kimmoli/saha-display-hw/doc/saha-display_2019-09-14.pdf

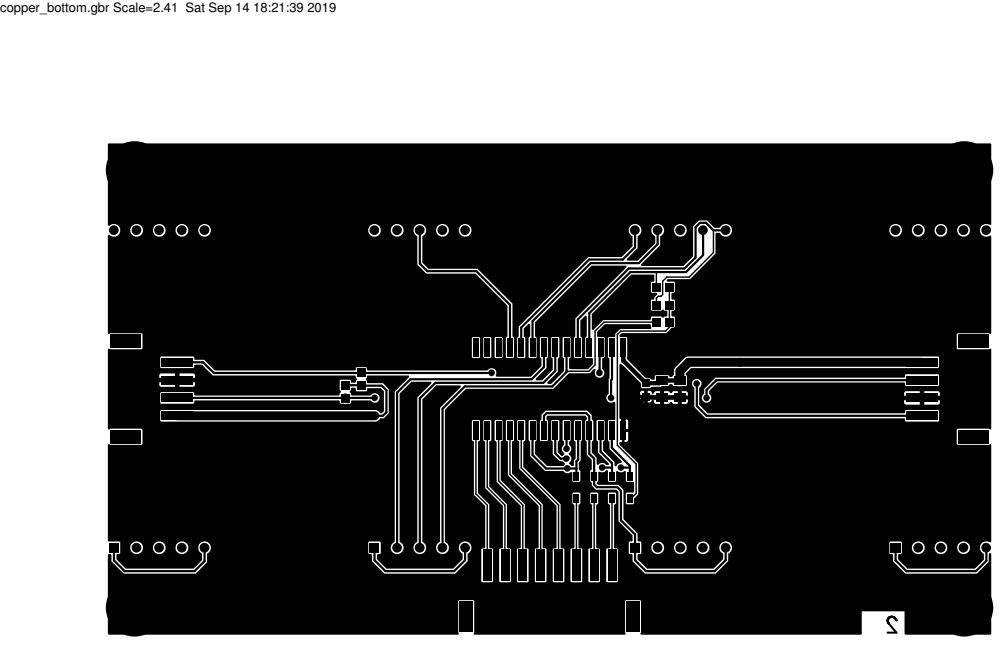
[picture p3: page 1]

copper_bottom.gbr Scale=2.41 Sat Sep 14 18:21:39 2019

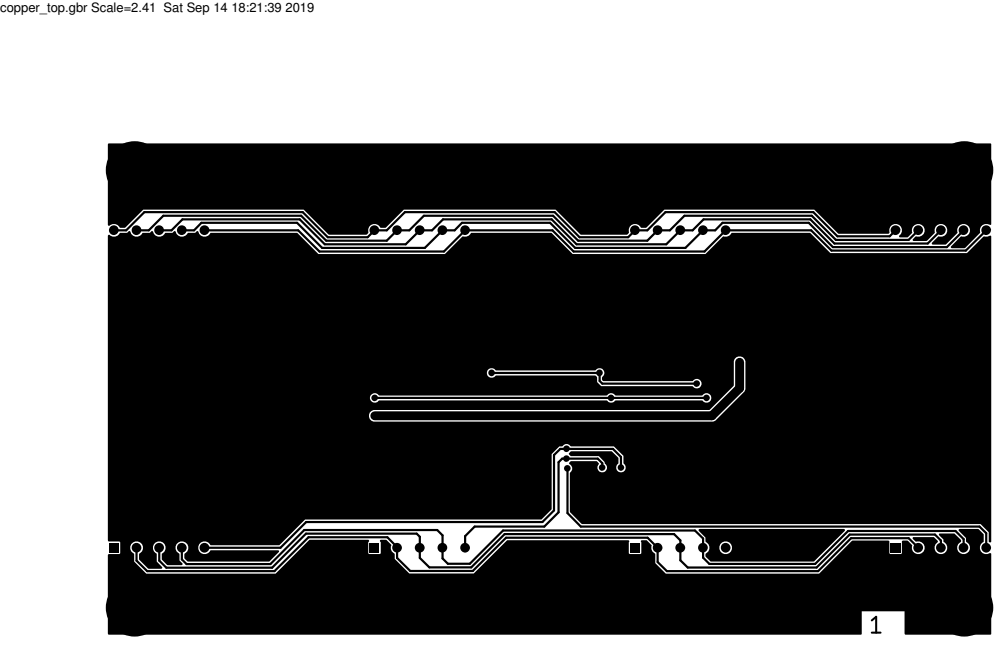
[picture p4: page 2]

copper_top.gbr Scale=2.41 Sat Sep 14 18:21:39 2019

profile.gbr Scale=2.41 Sat Sep 14 18:21:39 2019

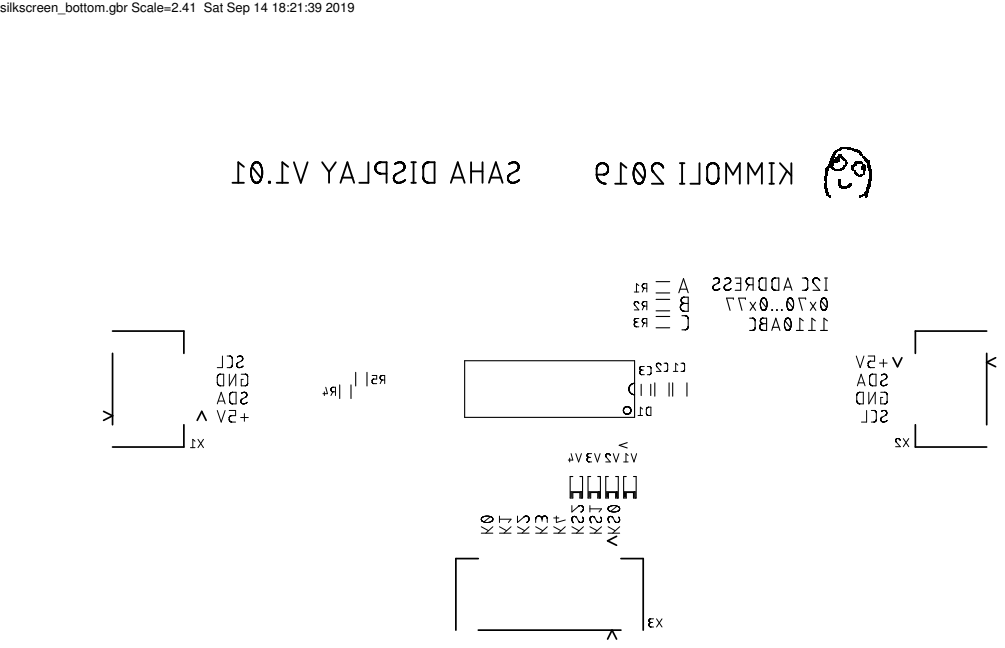
[picture p5: page 4]

silkscreen_bottom.gbr Scale=2.41 Sat Sep 14 18:21:39 2019

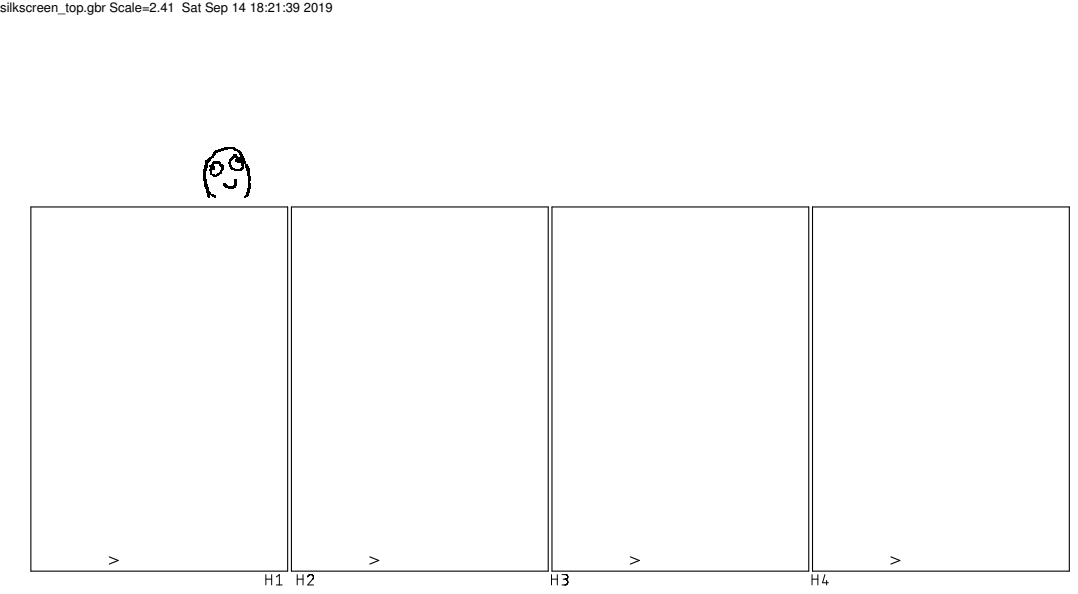
[picture p6: page 5]

silkscreen_top.gbr Scale=2.41 Sat Sep 14 18:21:39 2019

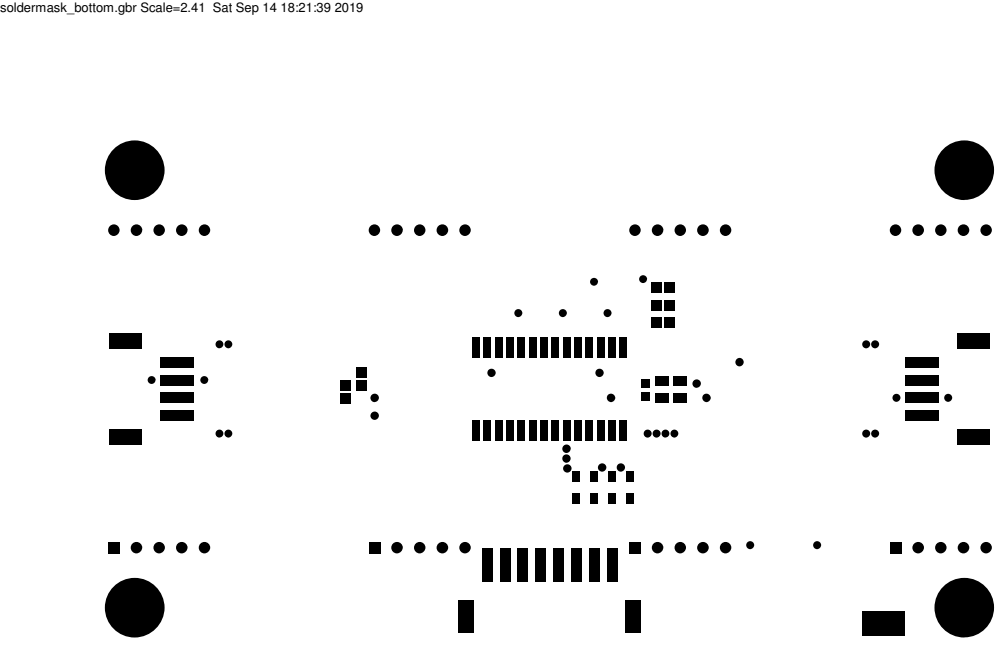
[picture p7: page 6]

soldermask_bottom.gbr Scale=2.41 Sat Sep 14 18:21:39 2019

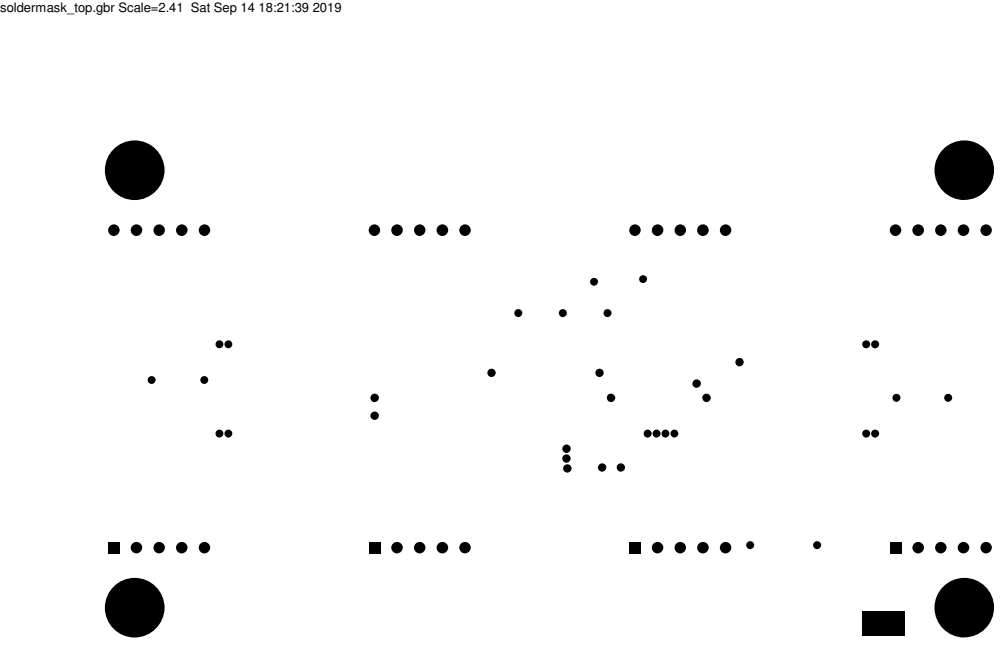
[picture p8: page 7]

soldermask_top.gbr Scale=2.41 Sat Sep 14 18:21:39 2019

solderpaste_bottom.gbr Scale=2.41 Sat Sep 14 18:21:39 2019

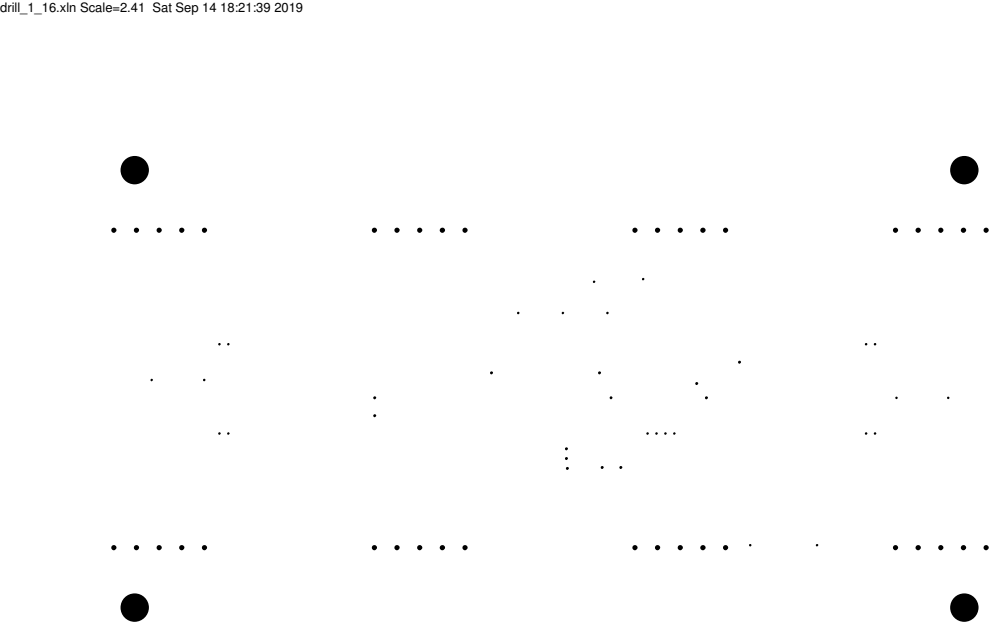
[picture p9: page 9]

drill_1_16.xln Scale=2.41 Sat Sep 14 18:21:39 2019
