kimmoli/saha-display-hw/doc/schema.pdf

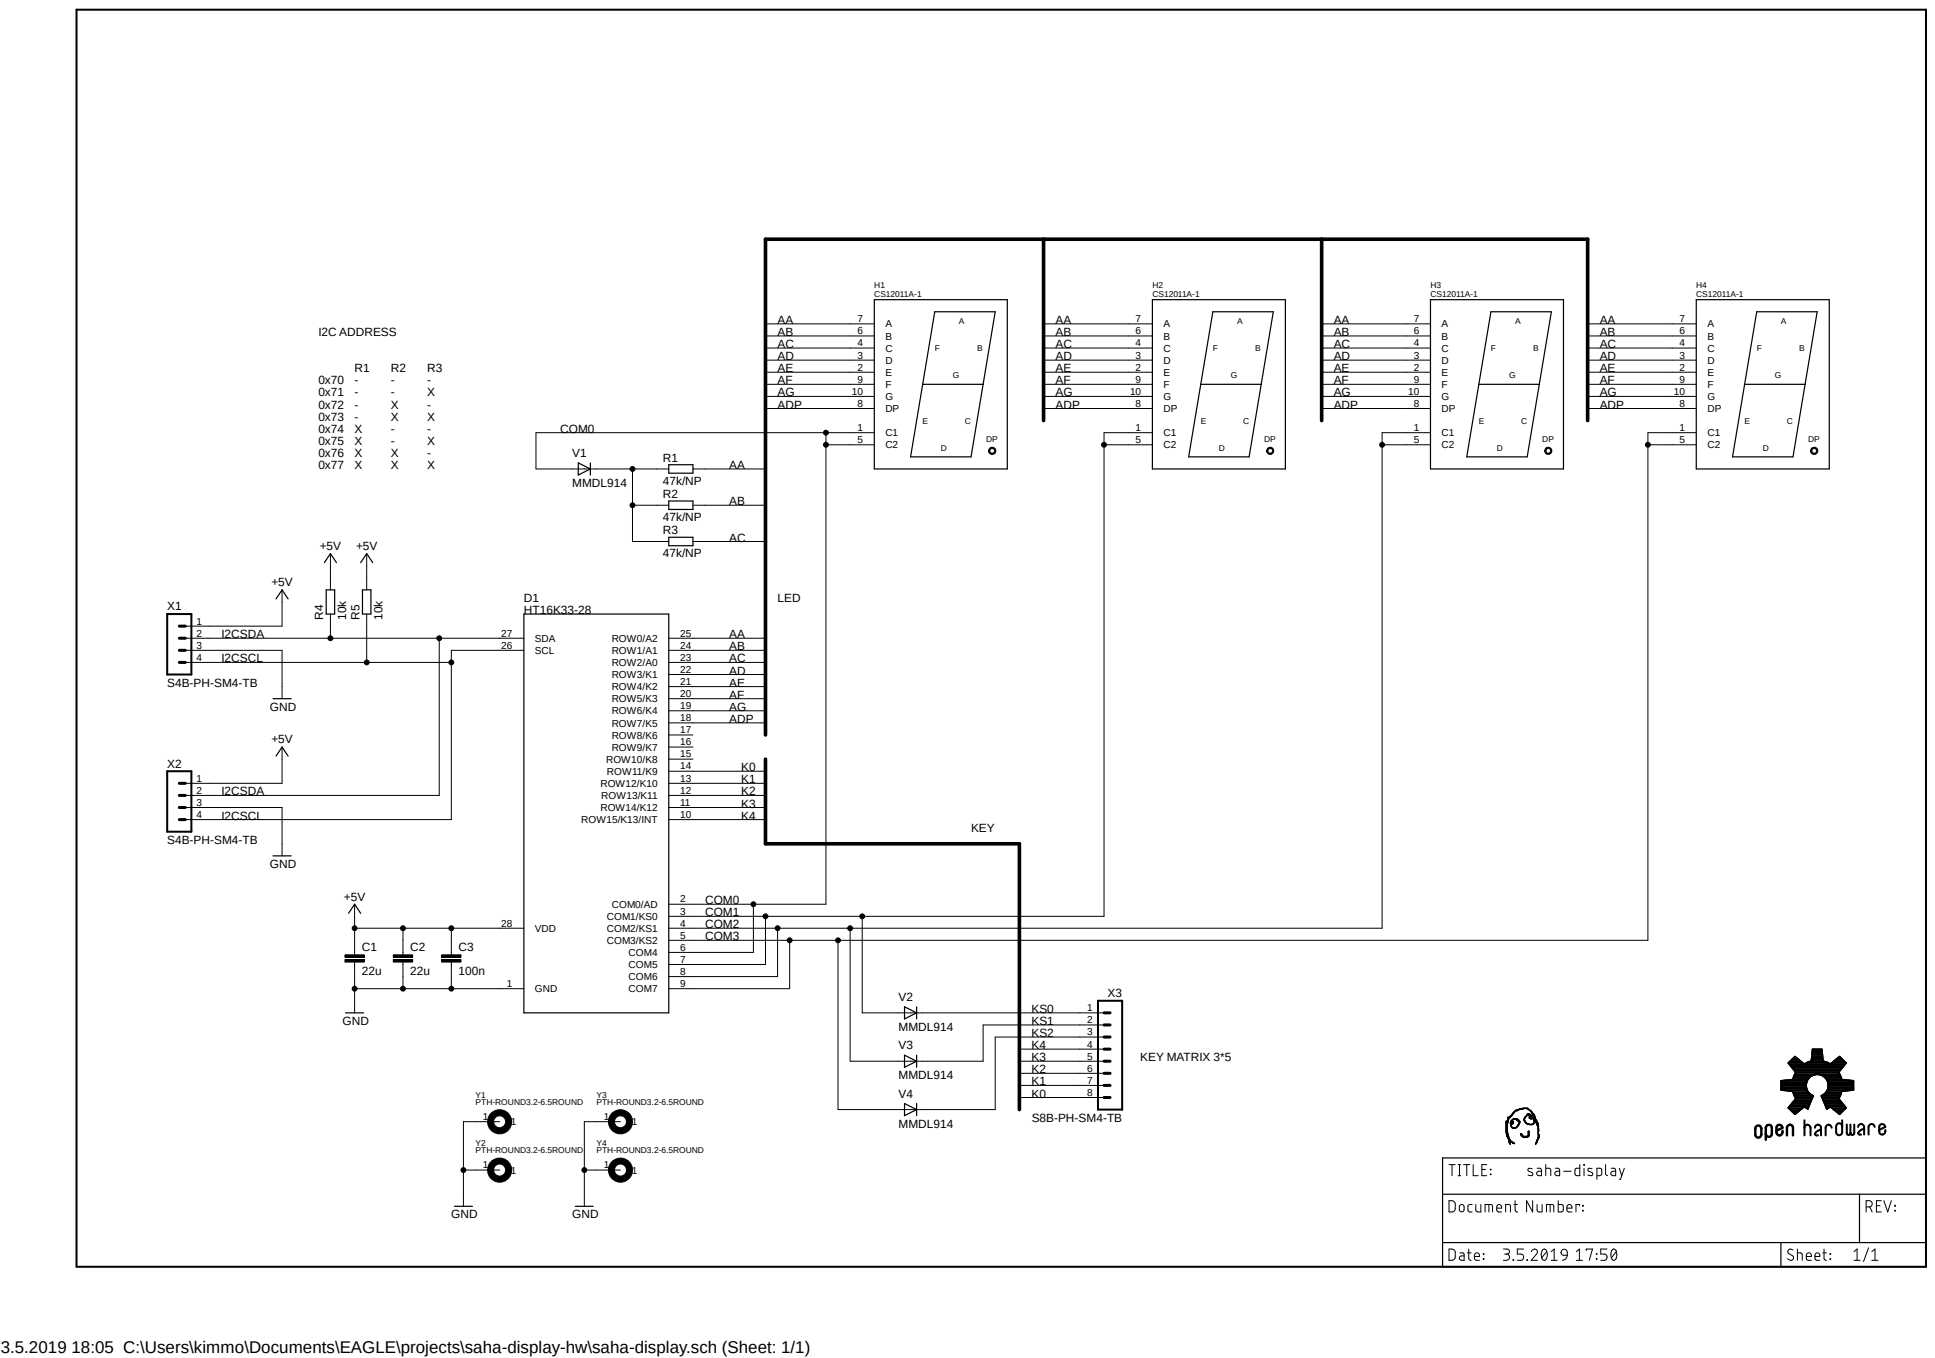
[picture p10: page 1]

KS1 2
KS2 3
K4 4

3.5.2019 18:05 C:\Users\kimmo\Documents\EAGLE\projects\saha-display-hw\saha-display.sch (Sheet: 1/1)
