kimmoli/saha-display-hw/saha-display.brd

## EAGLE design saha-display.brd (2019-09-14)

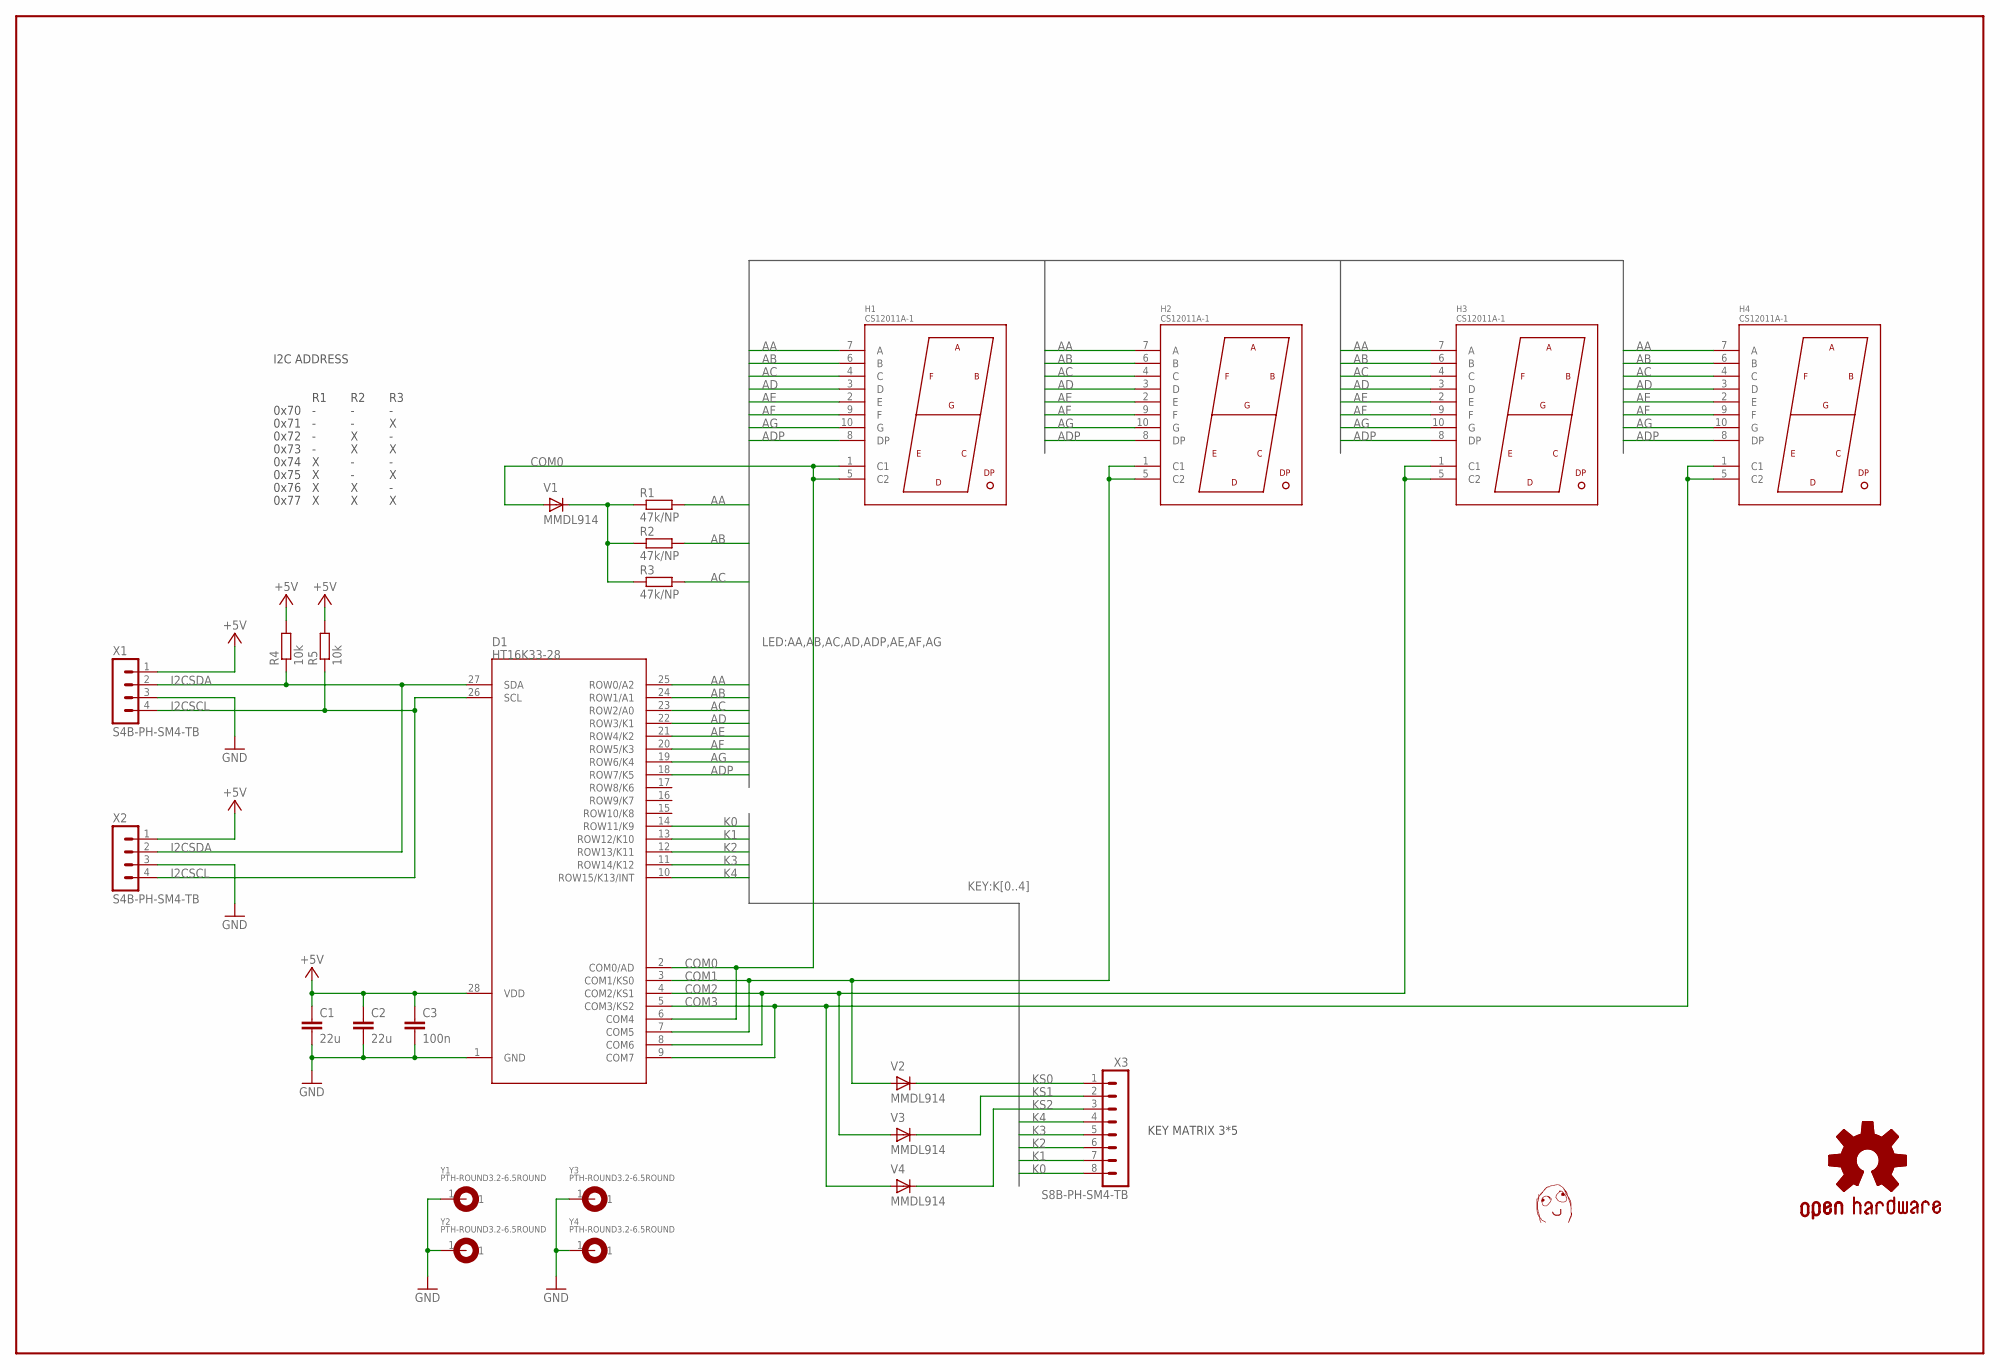
[picture p11: schematic saha-display.sch]

Parts:
C1, C2: 22u; C0805
C3: 100n; C0603
D1: HT16K33-28; SOP28-300
H1, H2, H3, H4: CS12011A-1; 7-SEGMENT-1.2INCH
R1, R2, R3: 47k/NP; R0603
R4, R5: 10k; R0603
U$1: DAFUG
V1, V2, V3, V4: MMDL914; SOD-323
X1, X2: S4B-PH-SM4-TB; JST-PH2.0-RA-4
X3: S8B-PH-SM4-TB; JST-PH2.0-RA-8
Y1, Y2, Y3, Y4: PTH-ROUND3.2-6.5ROUND; EKE_PTH-3.2-6.5

Connections:
+5V: C1.1, C2.1, C3.1, D1.28 (VDD), R4.2, R5.2, X1.1, X2.1
AA: D1.25 (ROW0/A2), H1.7 (A), H2.7 (A), H3.7 (A), H4.7 (A), R1.2
AB: D1.24 (ROW1/A1), H1.6 (B), H2.6 (B), H3.6 (B), H4.6 (B), R2.2
AC: D1.23 (ROW2/A0), H1.4 (C), H2.4 (C), H3.4 (C), H4.4 (C), R3.2
AD: D1.22 (ROW3/K1), H1.3 (D), H2.3 (D), H3.3 (D), H4.3 (D)
ADP: D1.18 (ROW7/K5), H1.8 (DP), H2.8 (DP), H3.8 (DP), H4.8 (DP)
AE: D1.21 (ROW4/K2), H1.2 (E), H2.2 (E), H3.2 (E), H4.2 (E)
AF: D1.20 (ROW5/K3), H1.9 (F), H2.9 (F), H3.9 (F), H4.9 (F)
AG: D1.19 (ROW6/K4), H1.10 (G), H2.10 (G), H3.10 (G), H4.10 (G)
COM0: D1.2 (COM0/AD), D1.6 (COM4), H1.1 (C1), H1.5 (C2), V1.A
COM1: D1.3 (COM1/KS0), D1.7 (COM5), H2.1 (C1), H2.5 (C2), V2.A
COM2: D1.4 (COM2/KS1), D1.8 (COM6), H3.1 (C1), H3.5 (C2), V3.A
COM3: D1.5 (COM3/KS2), D1.9 (COM7), H4.1 (C1), H4.5 (C2), V4.A
GND: C1.2, C2.2, C3.2, D1.1 (GND), X1.3, X2.3, Y1.1, Y2.1, Y3.1, Y4.1
I2CSCL: D1.26 (SCL), R5.1, X1.4, X2.4
I2CSDA: D1.27 (SDA), R4.1, X1.2, X2.2
K0: D1.14 (ROW11/K9), X3.8
K1: D1.13 (ROW12/K10), X3.7
K2: D1.12 (ROW13/K11), X3.6
K3: D1.11 (ROW14/K12), X3.5
K4: D1.10 (ROW15/K13/INT), X3.4
KS0: V2.C, X3.1
KS1: V3.C, X3.2
KS2: V4.C, X3.3
unnamed: R1.1, R2.1, R3.1, V1.C

Notes on the sheet:
I2C ADDRESS
0x70
0x71
0x72
0x73
0x74
0x75
0x76
0x77
KEY MATRIX 3*5

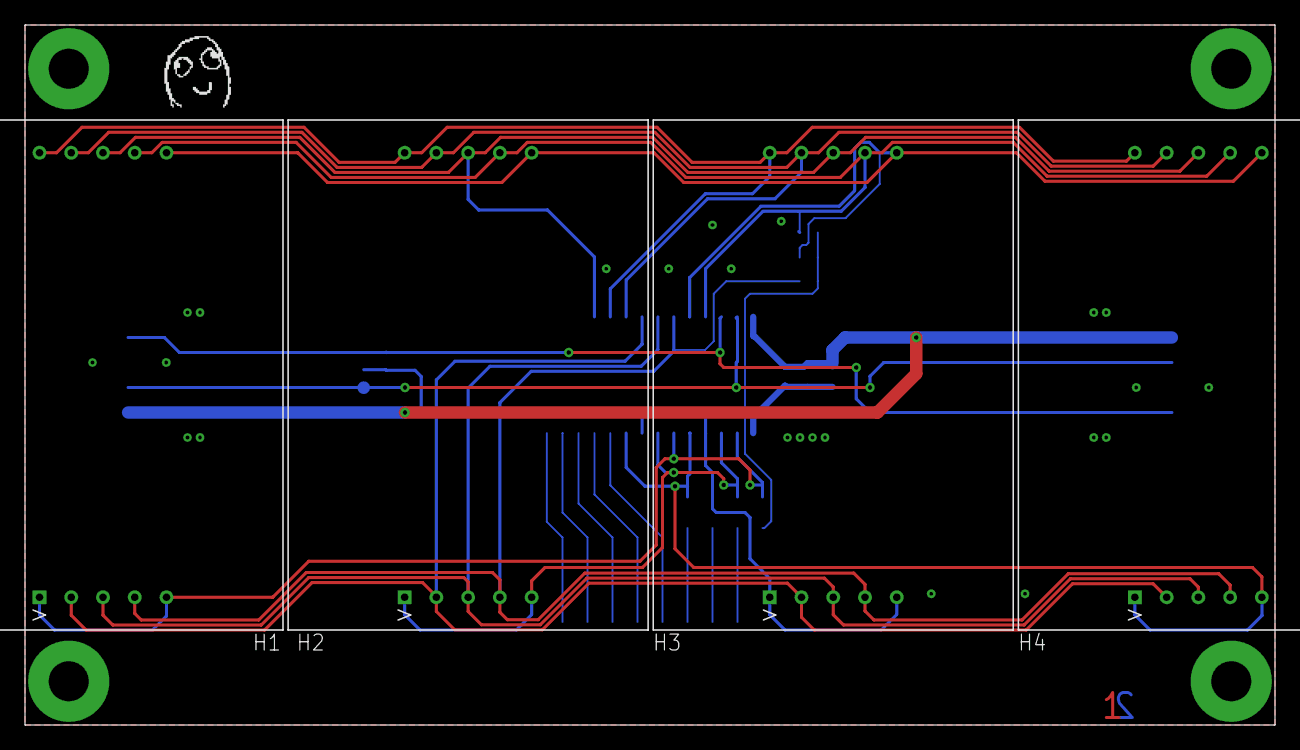
[picture p12: board saha-display.brd from above]

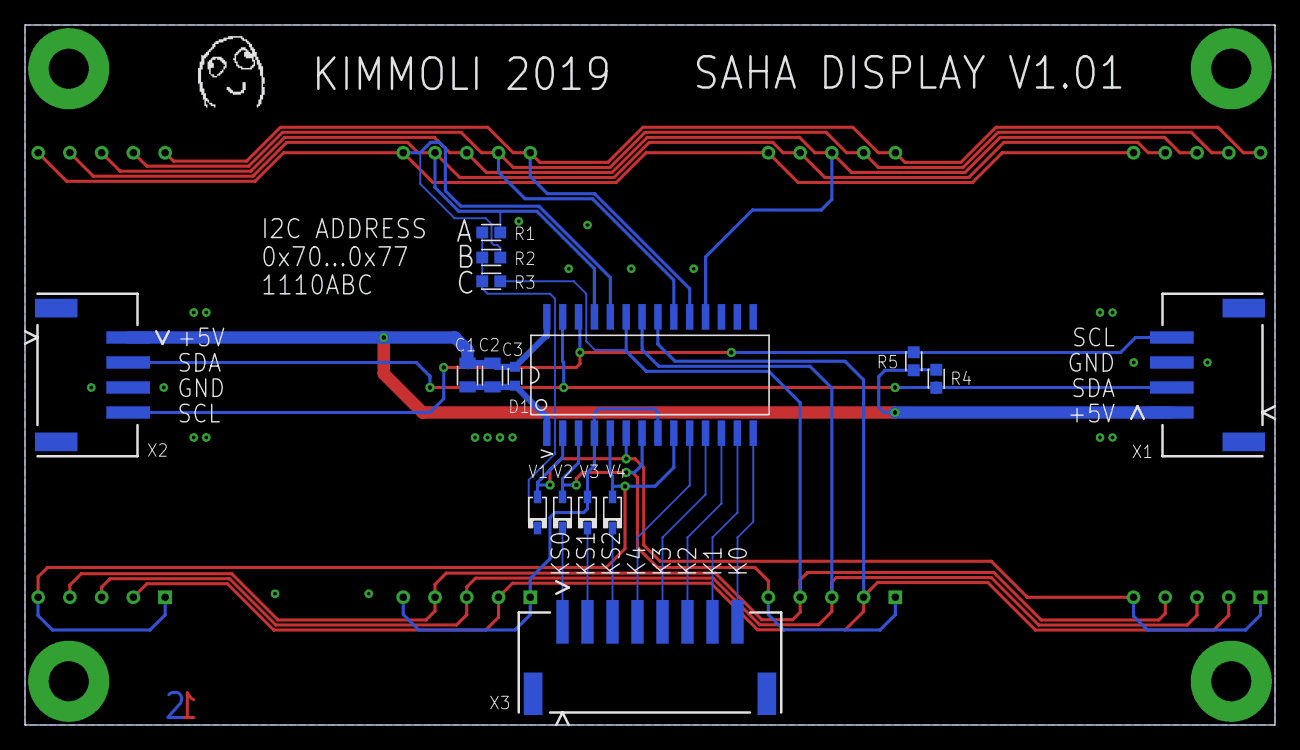
[picture p13: board saha-display.brd from below]

Board: 2 copper layers, 100.0 x 56.0 mm, 26 parts (17 on the bottom side), 25 nets.

Other parts of the board:
U$3: DAFUG
