kimmoli/saha-display-hw/(commit log)

2019-05-03 Layout complete
    [saha-display.brd, saha-display.sch]
2019-05-04 add layer window
    [saha-display.brd]
2019-05-04 fine tuning
    [saha-display.brd]
2019-09-14 fix layout v1.01
    [saha-display.brd]
